MaximeZhao/CASA0014_Sand_Clock/enclosure/IMG_2076.JPG

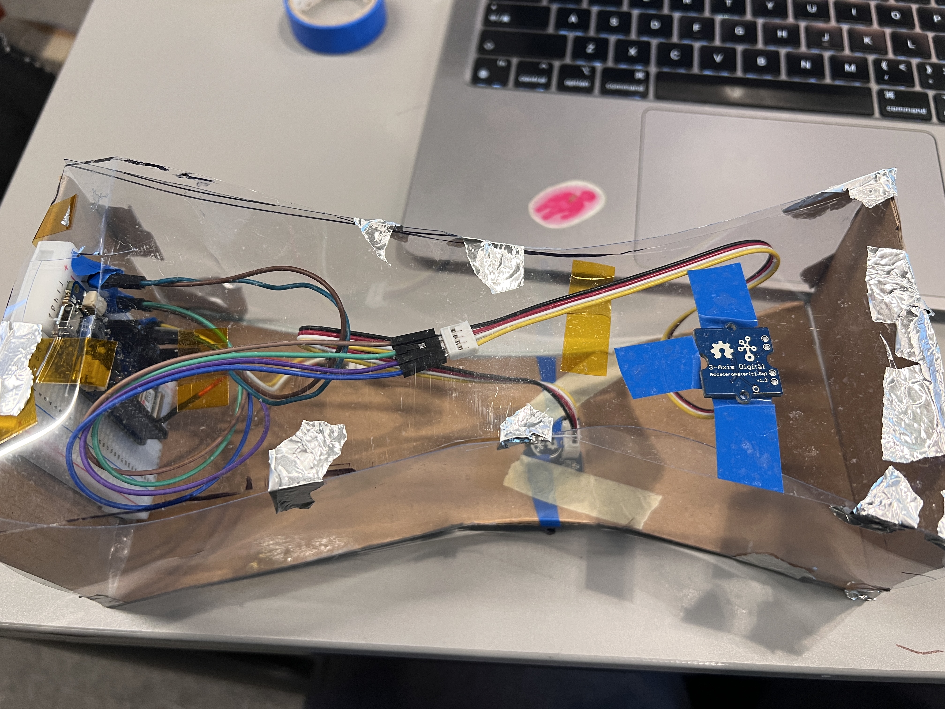
enclosure/IMG_2076.JPG
