MaximeZhao/CASA0014_Sand_Clock/docs/references.md

# References and acknowledgements

- [Arduino MKR WiFi1010 documentation](https://docs.arduino.cc/hardware/mkr-wifi-1010/)
- [Official MKR pinout](https://docs.arduino.cc/resources/pinouts/ABX00023-full-pinout.pdf)
- [Seeed Grove MMA7660 documentation](https://wiki.seeedstudio.com/Grove-3-Axis_Digital_Accelerometer-1.5g/)
- [Seeed MMA7660 library](https://github.com/Seeed-Studio/Accelerometer_MMA7660)
- [Seeed Grove Touch documentation](https://wiki.seeedstudio.com/Grove-Touch_Sensor/)
- [GitHub upload guidance](https://docs.github.com/en/repositories/working-with-files/managing-files/adding-a-file-to-a-repository)

Add the exact course starter-code source, lecture/readings and any adapted code attribution. Retain original source headers and licences in copied code. A project-wide licence has not been selected automatically.

See [AI usage disclosure](../AI_USAGE%2004.47.35.md).
