MaximeZhao/CASA0014_Sand_Clock/hardware/BOM.md

# Bill of materials

| Item | Quantity | Current role/status |
|---|---:|---|
| Arduino MKR WiFi1010 |1|Main controller, mounted on existing breadboard|
| Grove MMA7660 ±1.5g accelerometer |1|Motion input|
| Grove Touch v1.1 |1|Touch input|
| Breadboard82×55mm |1|Retained in current build|
| Grove cables and matching jumper adapters |As fitted|Preserve pin mapping, not colours|
| Micro-USB data/power cable |1|Current power and programming connection|
| Cardboard, transparent sheet, tape |As fitted|Medium-fidelity enclosure|
| LiPo battery |0installed|Attempt abandoned because connectors did not fit|

Record actual part dimensions, costs and sources if known; do not invent a purchase history.
