MaximeZhao/CASA0014_Sand_Clock/(commit log)

2026-11-03 Add files via upload
    Collect early Arduino sketches to document the technical development of the light-hourglass project.
    These files cover:
    - Tilt-switch input testing for the initial flip interaction (Tilt Sensor).
    - MMA7660 three-axis accelerometer readings for exploring orientation and movement.
    - MQTT communication and LED mapping tests for the Vespera installation.
    - Early light-hourglass animation experiments.
    The sketches are retained as development references rather than the final application. They help explain the progression from individual component tests towards the integrated prototype.
    This upload collects previously developed files retrospectively; it does not re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
    [Light_Hourglass_Test.ino, MMA7660FC_Demo.ino, Tilt_Module_Test.ino]
2026-11-03 Add files via upload
    structure of project, including readme file, AI usage, enclosure, docs, development iterations, hardware
2026-11-04 Add files via upload
    prototype
